vitaldb/snuadc/case_label/design.pdf

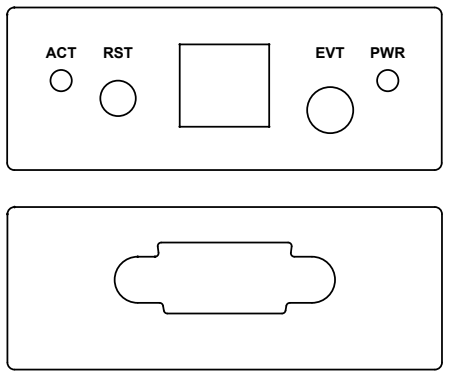
[picture p1: figure]
ACT; RST; EVT PWR
