vitaldb/snuadc/part_list/event jack 2.5mm.pdf

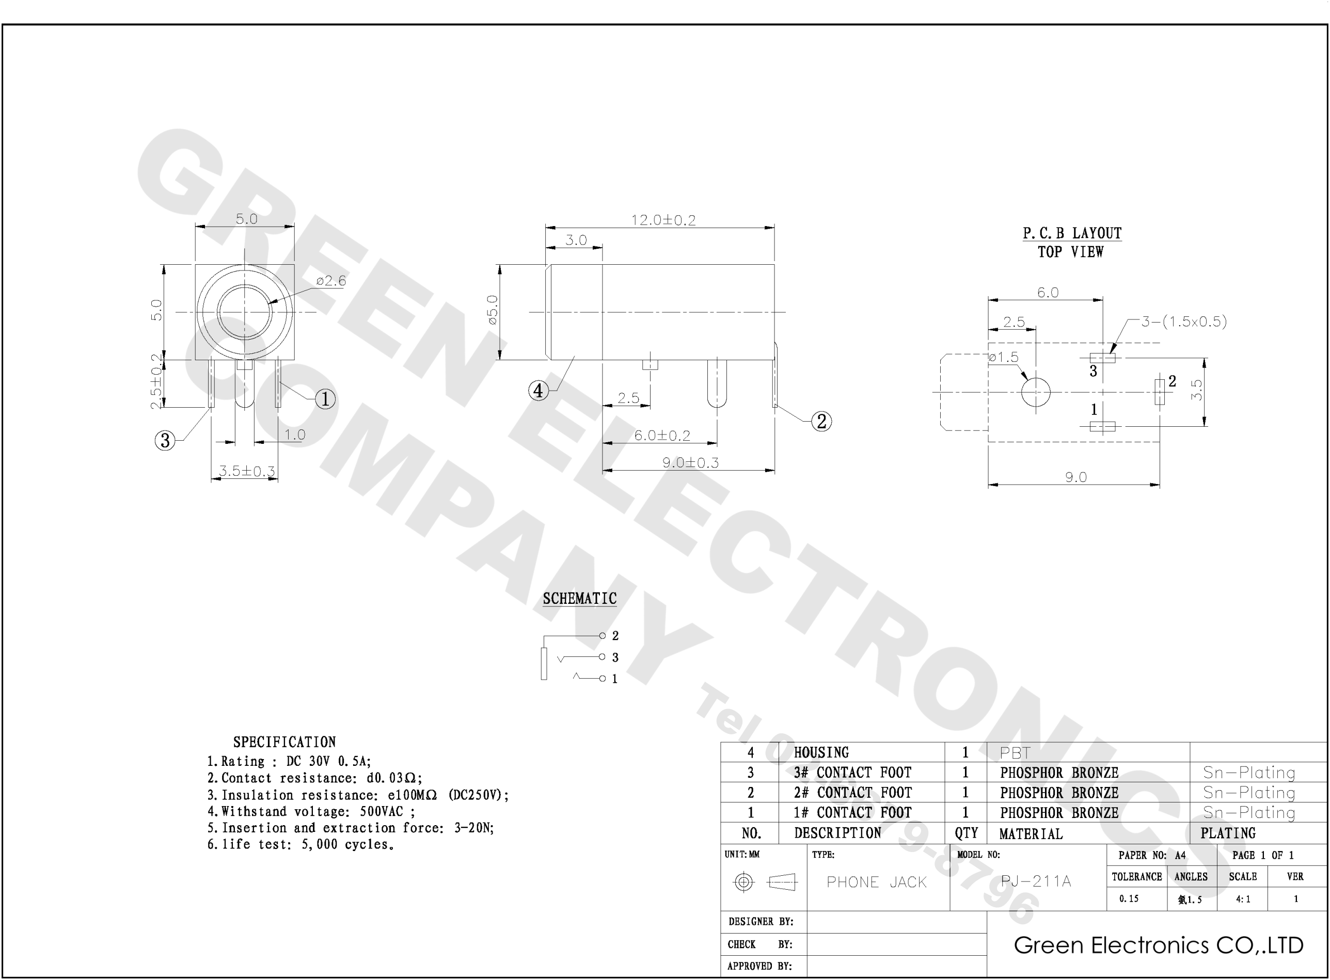
[picture p2: page 1]

Tel02-6679-8796
