vitaldb/snuadc/case_label/front.DXF

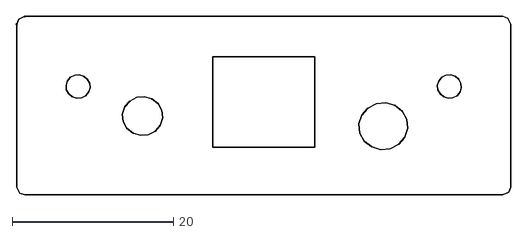
[picture p3: CAD file, 2018-11-22]
case_label/front.DXF
61.3 x 22.2
