vitaldb/snuadc/(list of files, cad)

Other CAD files:
case_label/frontback.SLDPRT
case_label/frontback.DXF
