vitaldb/snuadc/artwork/schematic.pdf

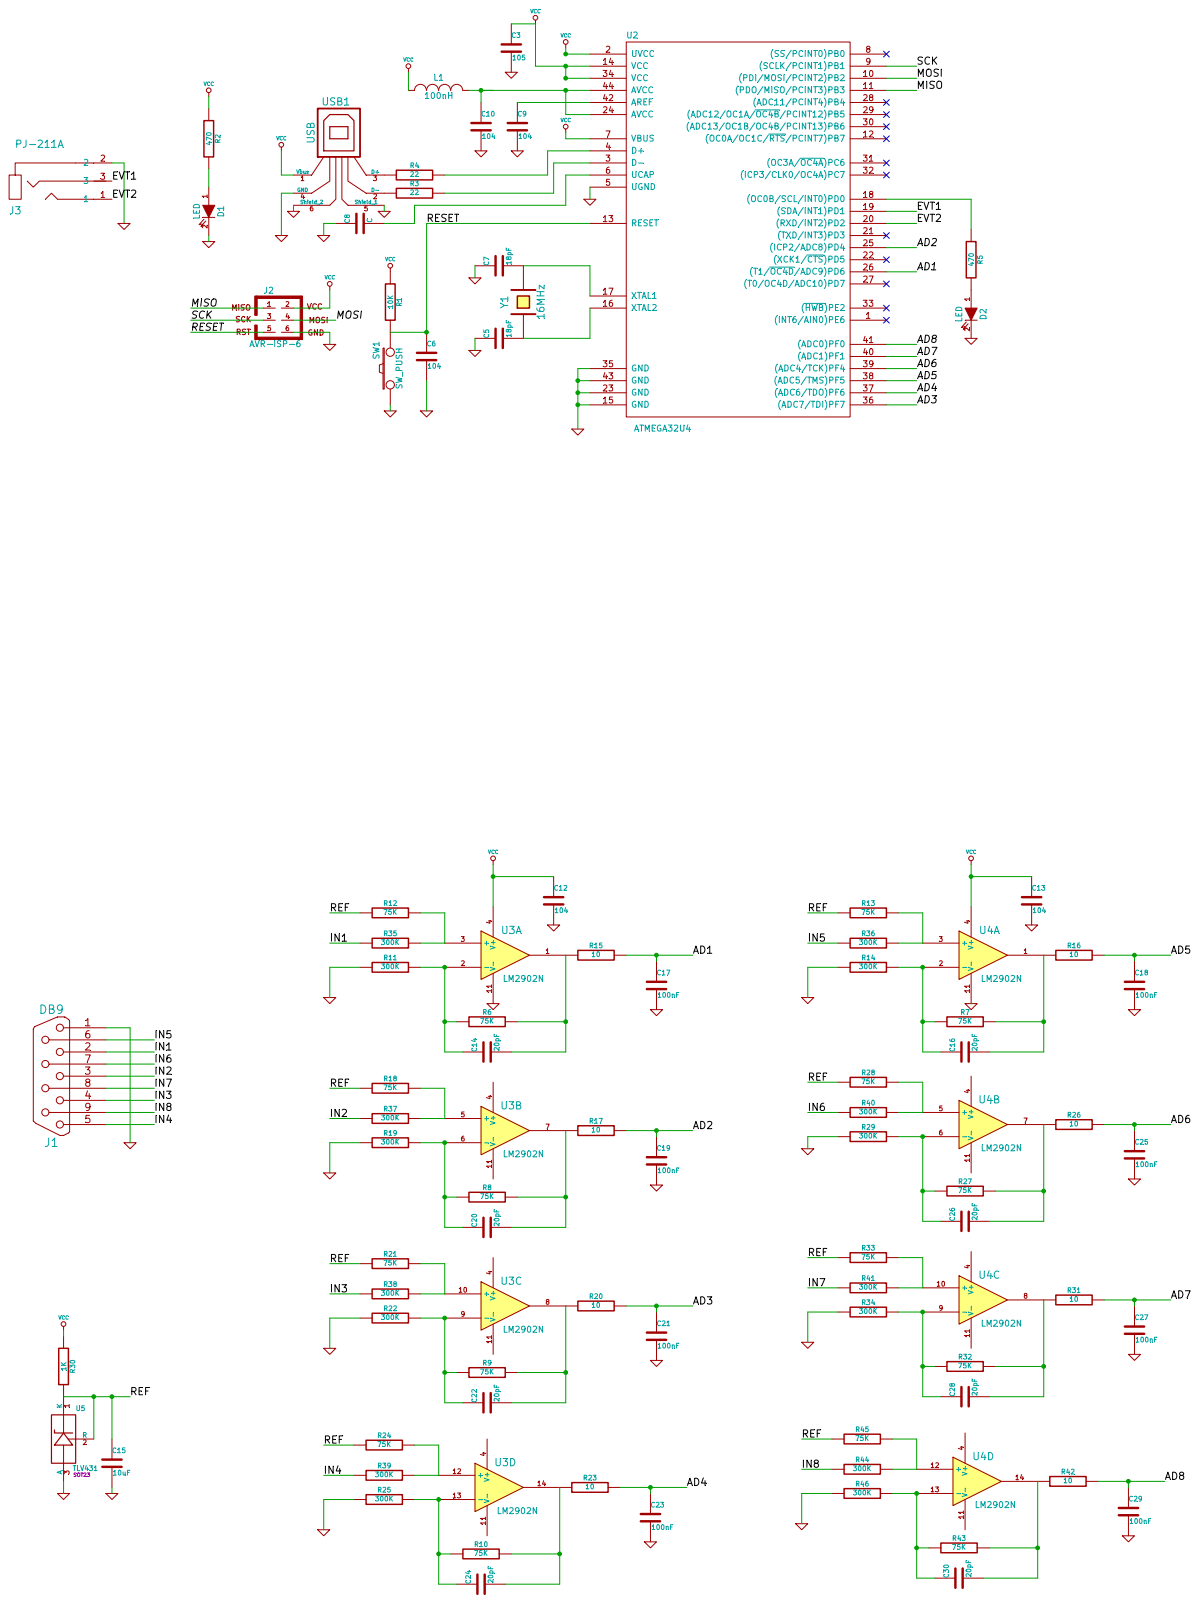
[picture p4: page 1]
