vitaldb/snuadc/part_list/snuadc case.pdf

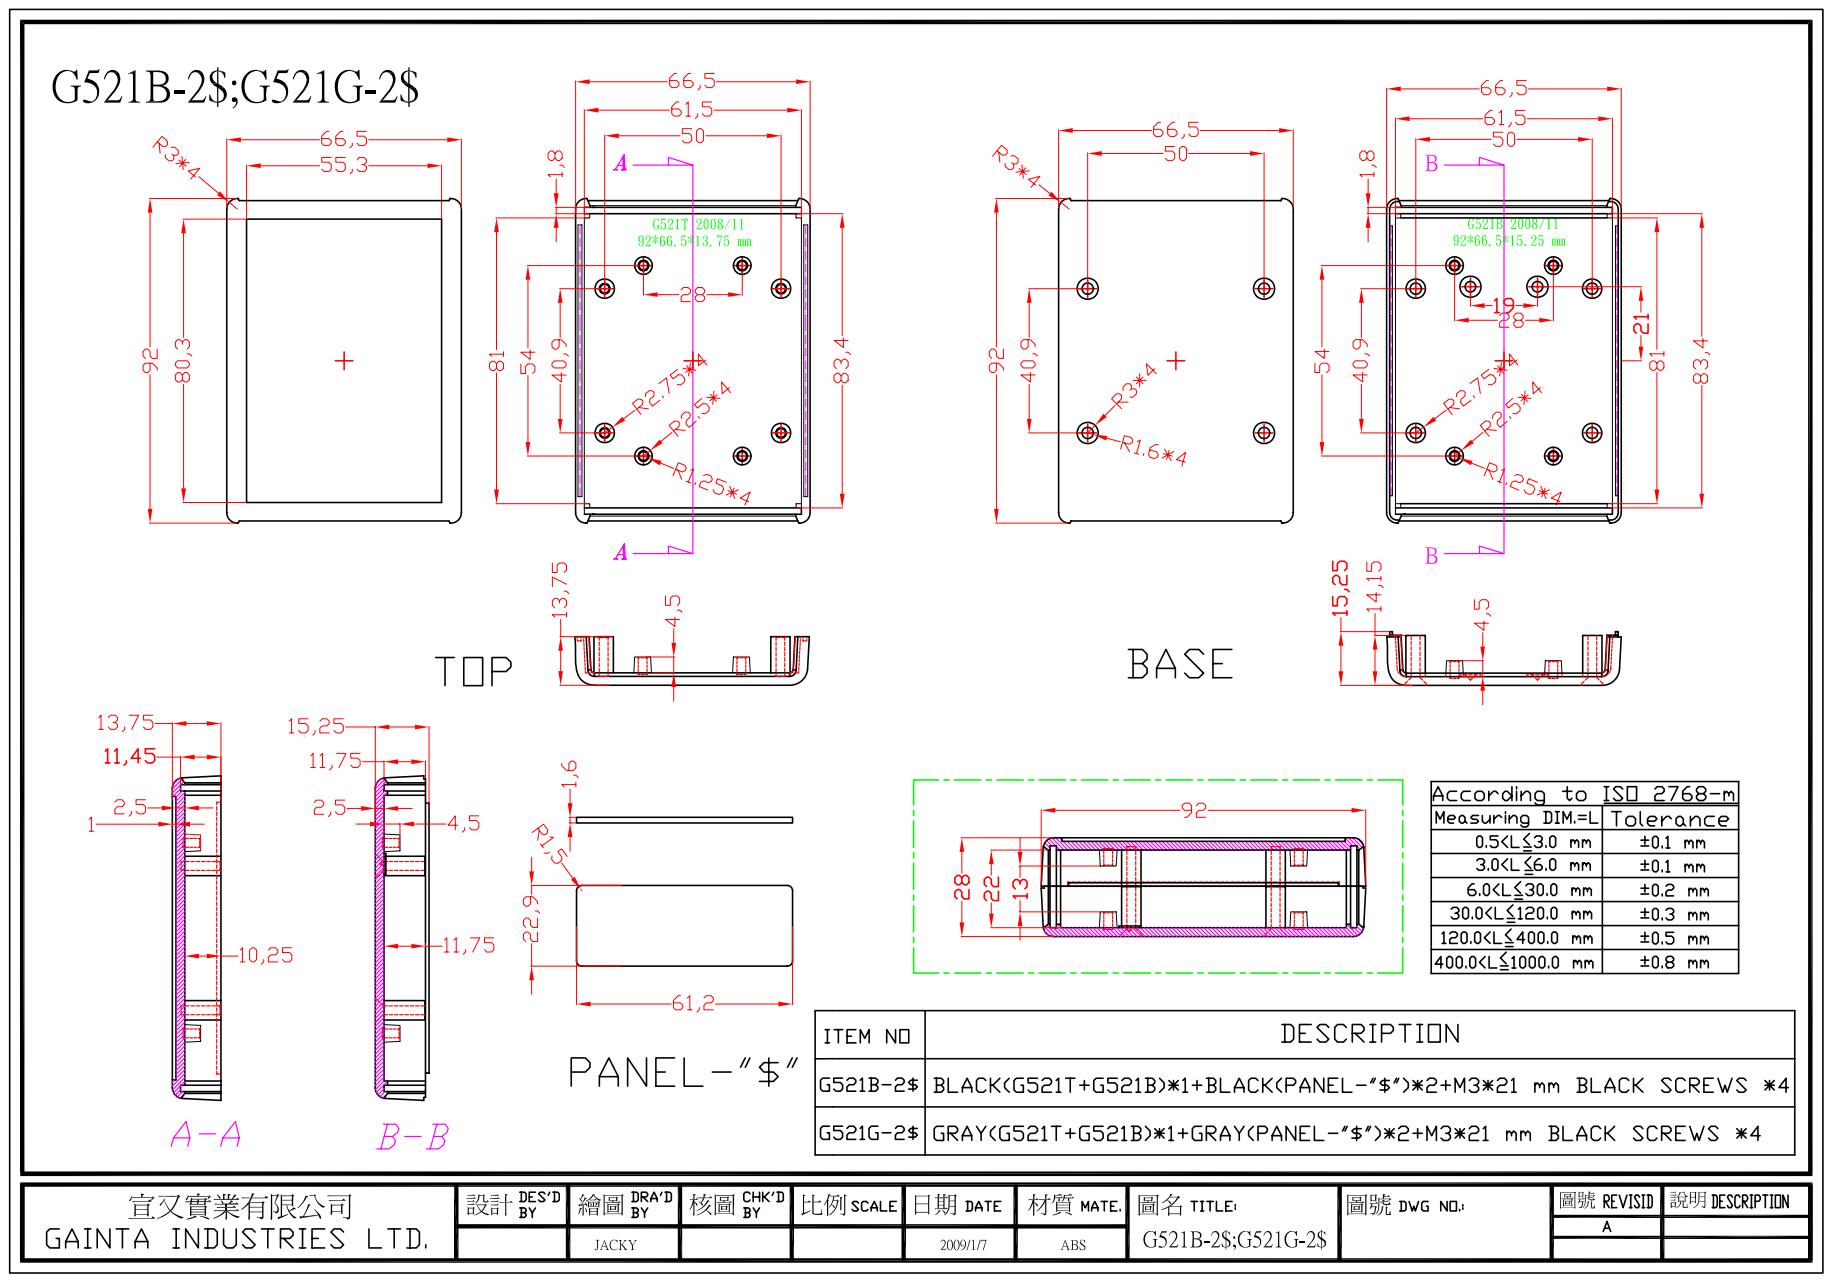
[picture p5: page 1]
