vitaldb/snuadc/artwork/snuadc.kicad_pcb

## KiCad design artwork/snuadc.kicad_pcb (2018-11-22)

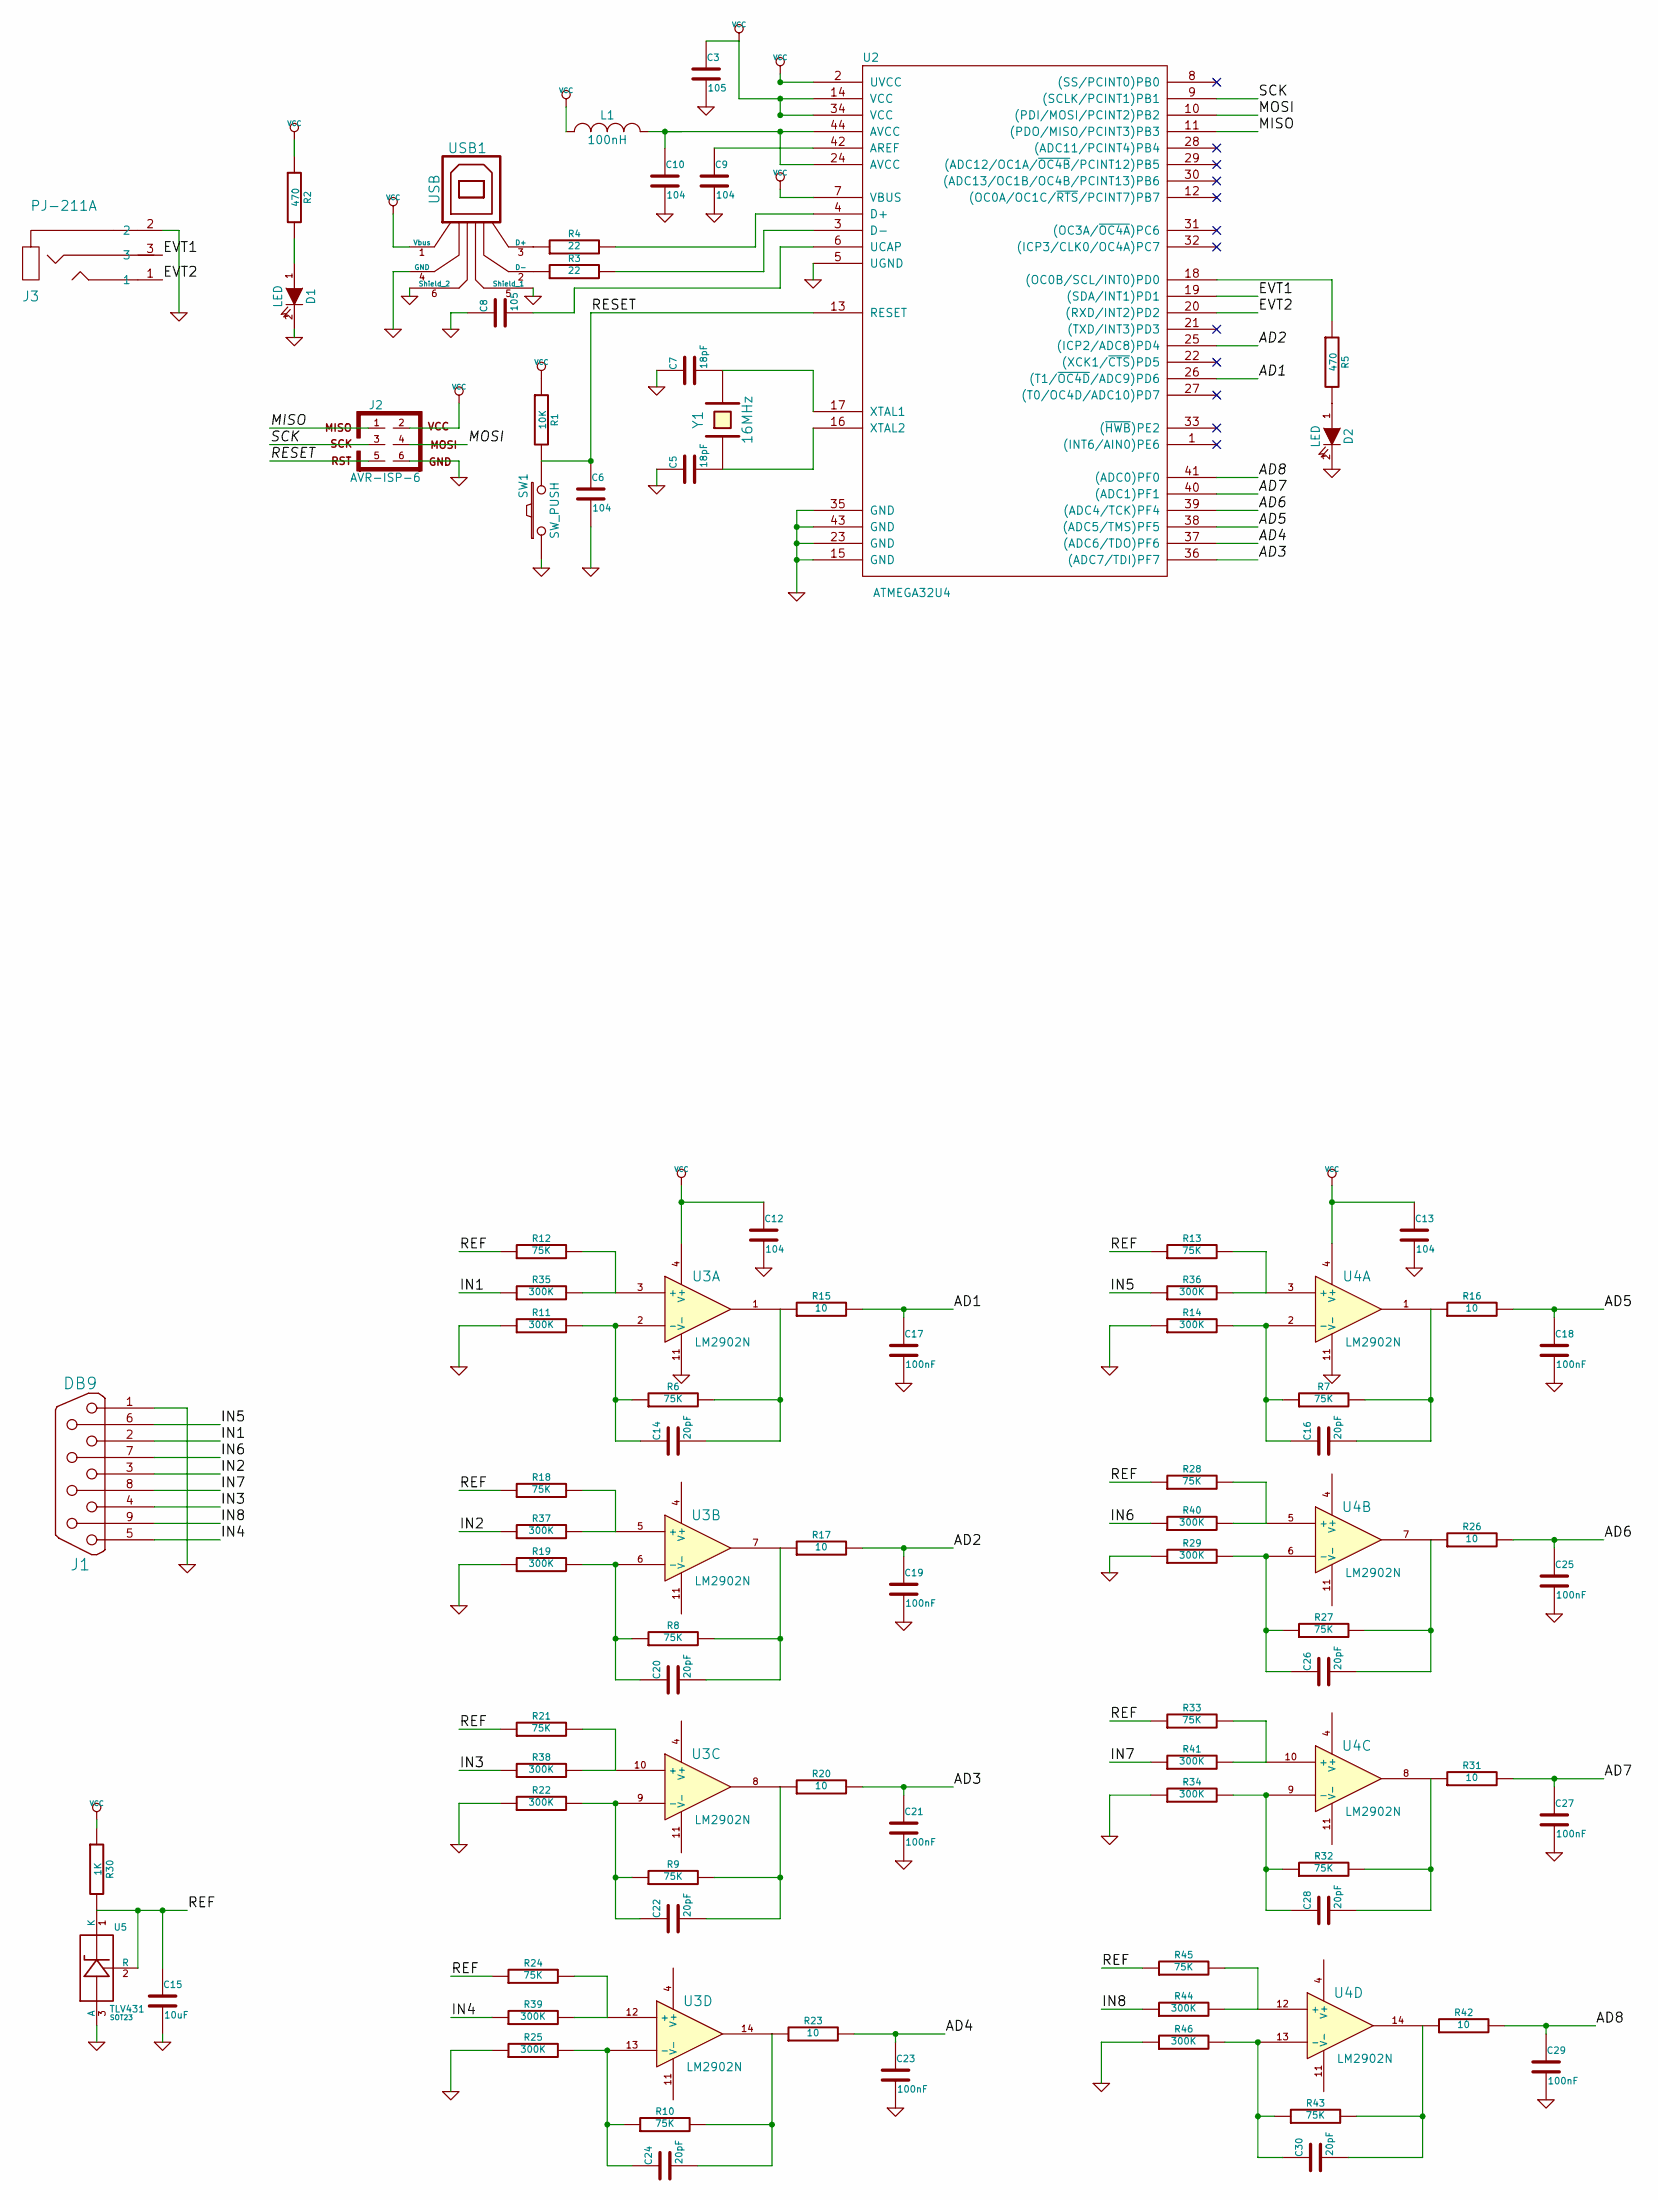
[picture p6: schematic snuadc.sch, noname.sch]

Parts:
C3, C8: 105
C5, C7: 18pF
C6, C9, C10, C12, C13: 104
C14, C16, C20, C22, C24, C26, C28, C30: 20pF
C15: 10uF
C17, C18, C19, C21, C23, C25, C27, C29: 100nF
D1, D2: LED
J1: DB9
J2: AVR-ISP-6
J3: PJ-211A
L1: 100nH
R1: 10K
R2, R5: 470
R3, R4: 22
R6, R7, R8, R9, R10, R12, R13, R18, R21, R24, R27, R28, R32, R33, R43, R45: 75K
R11, R14, R19, R22, R25, R29, R34, R35, R36, R37, R38, R39, R40, R41, R44, R46: 300K
R15, R16, R17, R20, R23, R26, R31, R42: 10
R30: 1K
SW1: SW_PUSH
U2: ATMEGA32U4
U3, U4: LM2902N
U5: TLV431; SOT23
USB1: USB
Y1: 16MHz

Connections:
/AD1: C17.1, R15.2, U2.26 ((T1/~OC4D~/ADC9)PD6)
/AD2: C19.1, R17.2, U2.25 ((ICP2/ADC8)PD4)
/AD3: C21.1, R20.2, U2.36 ((ADC7/TDI)PF7)
/AD4: C23.1, R23.2, U2.37 ((ADC6/TDO)PF6)
/AD5: C18.1, R16.2, U2.38 ((ADC5/TMS)PF5)
/AD6: C25.1, R26.2, U2.39 ((ADC4/TCK)PF4)
/AD7: C27.1, R31.2, U2.40 ((ADC1)PF1)
/AD8: C29.1, R42.2, U2.41 ((ADC0)PF0)
/EVT1: J3.3, U2.19 ((SDA/INT1)PD1)
/EVT2: J3.1, U2.20 ((RXD/INT2)PD2)
/IN1: J1.2, R35.1
/IN2: J1.3, R37.1
/IN3: J1.4, R38.1
/IN4: J1.5, R39.1
/IN5: J1.6, R36.1
/IN6: J1.7, R40.1
/IN7: J1.8, R41.1
/IN8: J1.9, R44.1
/MISO: J2.1, U2.11 ((PDO/MISO/PCINT3)PB3)
/MOSI: J2.4, U2.10 ((PDI/MOSI/PCINT2)PB2)
/REF: C15.1, R12.1, R13.1, R18.1, R21.1, R24.1, R28.1, R30.2, R33.1, R45.1, U5.1 (K), U5.2 (R)
/RESET: C6.1, J2.5, R1.2, SW1.2, U2.13 (RESET)
/SCK: J2.3, U2.9 ((SCLK/PCINT1)PB1)
GND: C3.2, C5.1, C6.2, C7.1, C8.1, C9.2, C10.2, C12.2, C13.2, C15.2, C17.2, C18.2, C19.2, C21.2, C23.2, C25.2, C27.2, C29.2, D1.2 (K), D2.2 (K), J1.1, J2.6, J3.2, R11.1, R14.1, R19.1, R22.1, R25.1, R29.1, R34.1, R46.1, SW1.1, U2.5 (UGND), U2.15 (GND), U2.23 (GND), U2.35 (GND), U2.43 (GND), U3.11 (V-), U4.11 (V-), U5.3 (A), USB1.4 (GND), USB1.5 (Shield_1), USB1.6 (Shield_2)
unnamed: C20.2, R8.2, R17.1, U3.7
unnamed: C20.1, R8.1, R19.2, U3.6 (-)
unnamed: R28.2, R40.2, U4.5 (+)
unnamed: C26.1, R27.1, R29.2, U4.6 (-)
unnamed: R13.2, R36.2, U4.3 (+)
unnamed: C16.2, R7.2, R16.1, U4.1
unnamed: C26.2, R26.1, R27.2, U4.7
unnamed: C16.1, R7.1, R14.2, U4.2 (-)
unnamed: R18.2, R37.2, U3.5 (+)
unnamed: C22.2, R9.2, R20.1, U3.8
unnamed: R33.2, R41.2, U4.10 (+)
unnamed: C22.1, R9.1, R22.2, U3.9 (-)
unnamed: C28.1, R32.1, R34.2, U4.9 (-)
unnamed: C28.2, R31.1, R32.2, U4.8
unnamed: R21.2, R38.2, U3.10 (+)
unnamed: C7.2, U2.17 (XTAL1), Y1.2
unnamed: C14.2, R6.2, R15.1, U3.1
unnamed: R12.2, R35.2, U3.3 (+)
unnamed: C14.1, R6.1, R11.2, U3.2 (-)
unnamed: D1.1 (A), R2.2
unnamed: R4.2, U2.4 (D+)
unnamed: C5.2, U2.16 (XTAL2), Y1.1
unnamed: R3.2, U2.3 (D-)
unnamed: C8.2, U2.6 (UCAP)
unnamed: R44.2, R45.2, U4.12 (+)
unnamed: C30.1, R43.1, R46.2, U4.13 (-)
unnamed: C30.2, R42.1, R43.2, U4.14
unnamed: R24.2, R39.2, U3.12 (+)
unnamed: C24.1, R10.1, R25.2, U3.13 (-)
unnamed: C24.2, R10.2, R23.1, U3.14
unnamed: C9.1, U2.42 (AREF)
unnamed: C10.1, L1.2, U2.24 (AVCC), U2.44 (AVCC)
unnamed: R5.1, U2.18 ((OC0B/SCL/INT0)PD0)
unnamed: D2.1 (A), R5.2
unnamed: R3.1, USB1.2 (D-)
unnamed: R4.1, USB1.3 (D+)
VCC: C3.1, C12.1, C13.1, J2.2, L1.1, R1.1, R2.1, R30.1, U2.2 (UVCC), U2.7 (VBUS), U2.14 (VCC), U2.34 (VCC), U3.4 (V+), U4.4 (V+), USB1.1 (Vbus)

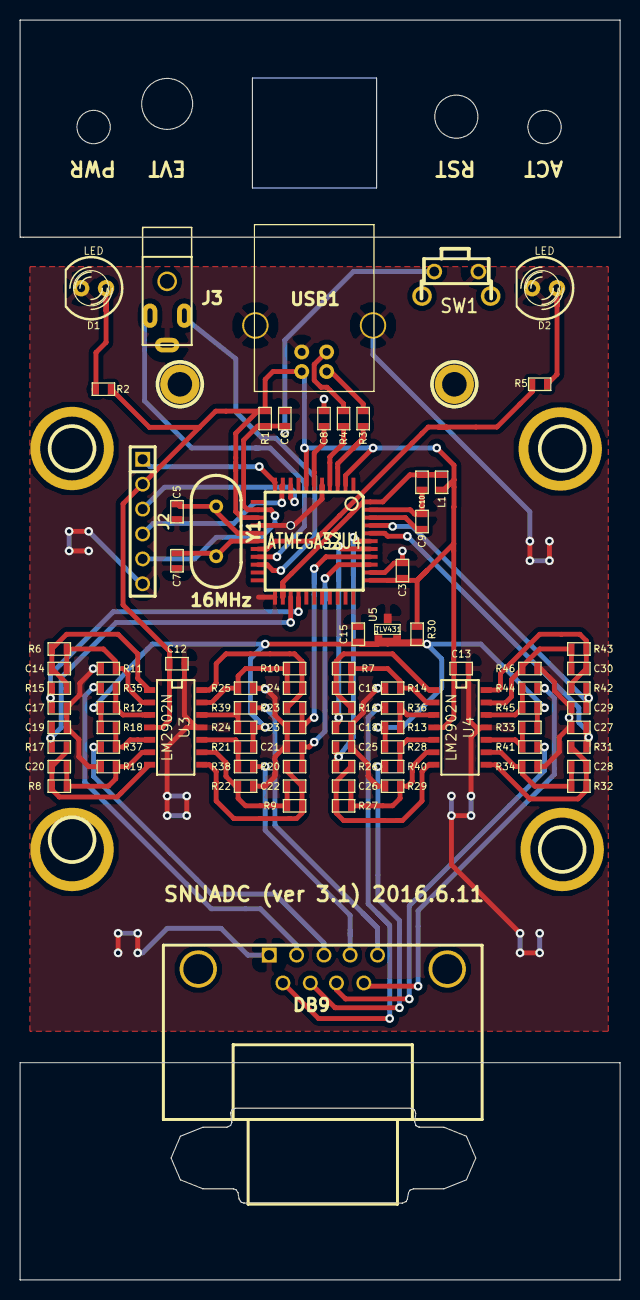
[picture p7: board snuadc.kicad_pcb from above]

Board: 2 copper layers, 61.2 x 128.5 mm, 84 parts (0 on the bottom side), 53 nets.
